Tomgroot/zigbee-indicator-light/hardware/reference/ESP32-H2-Zero-size.jpg

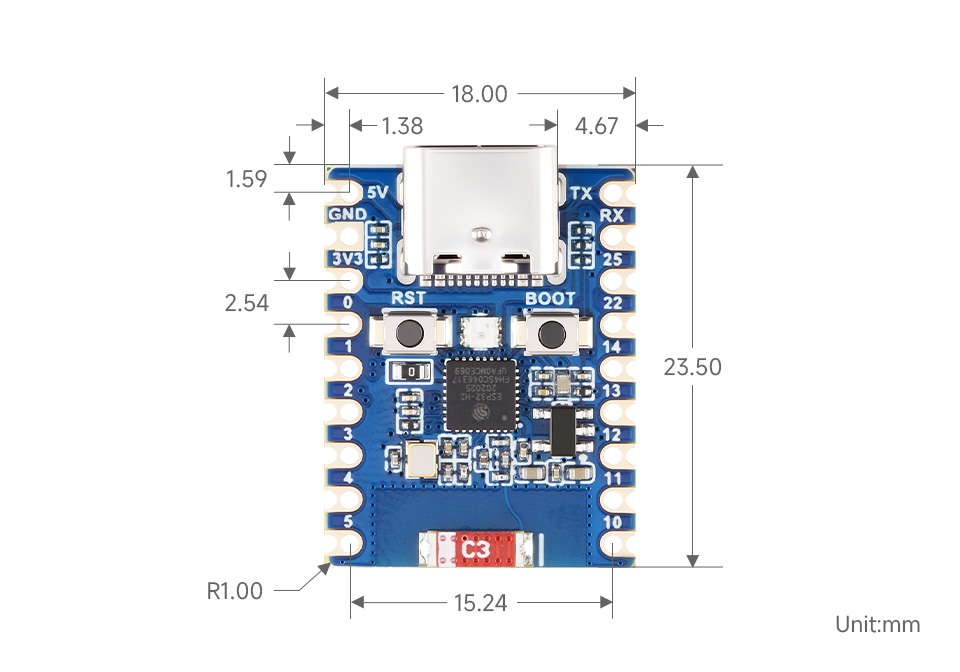
hardware/reference/ESP32-H2-Zero-size.jpg
