Tomgroot/zigbee-indicator-light/hardware/circuit_diagram.png

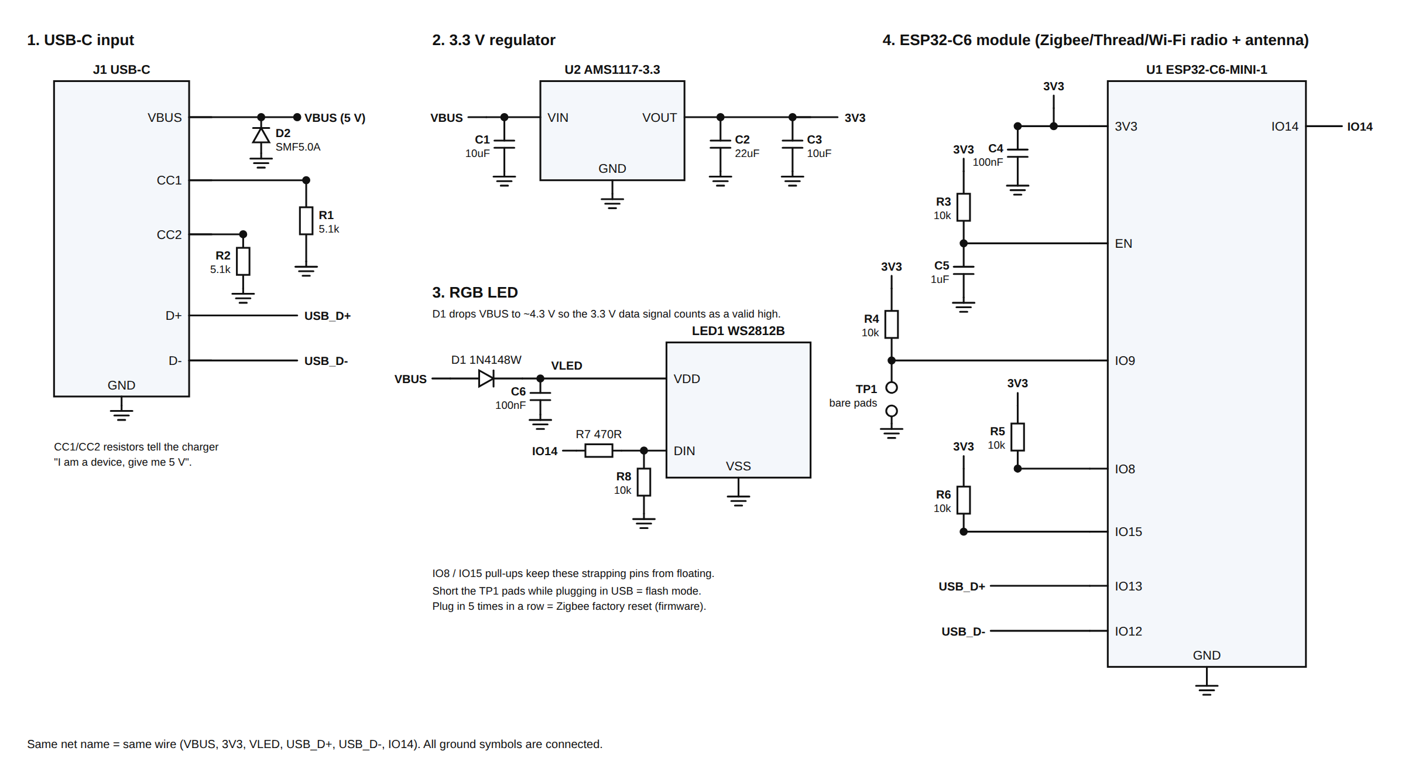
hardware/circuit_diagram.png
