Tomgroot/zigbee-indicator-light/hardware/bom.csv

Comment | Designator | Footprint | JLCPCB Part #（optional） | JLC type
ESP32-C6-MINI-1-N4 | U1 | ESP32-C6-MINI-1 | C5736265 | Extended
AP2114H-3.3 | U2 | SOT-223 | C150716 | Extended
TYPE-C-31-M-12 (USB-C 16p) | J1 | USB-C SMD | C165948 | Extended
WS2812B-B-V6 | LED1 | 5050 | C52941391 | Extended
1N4148W | D1 | SOD-123 | C81598 | Basic
SMF5.0A (TVS) | D2 | SOD-123FL | C151296 | Extended
22uF | C2 | 0805 | C45783 | Basic
10uF | C1,C3 | 0805 | C15850 | Basic
1uF | C5 | 0603 | C15849 | Basic
100nF | C4,C6 | 0603 | C14663 | Basic
10k | R3,R4,R5,R6,R8 | 0603 | C25804 | Basic
5.1k | R1,R2 | 0603 | C23186 | Basic
470R | R7 | 0603 | C23179 | Basic
