Tomgroot/zigbee-indicator-light/hardware/base_indicator_light.stl

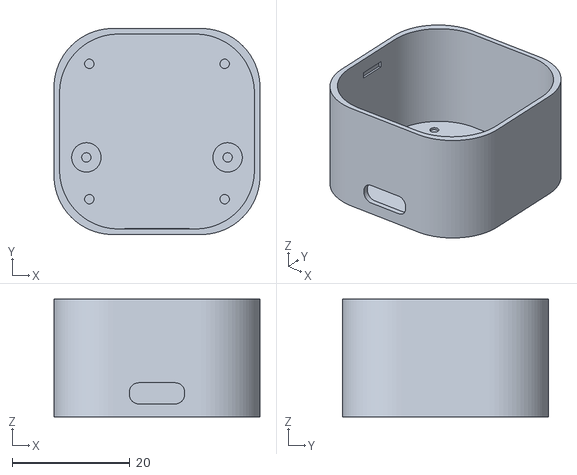
[picture p3: CAD file, 2026-11-05]
hardware/base_indicator_light.stl
35.0 x 35.0 x 20.0
