Tomgroot/zigbee-indicator-light/hardware/board_outline.dxf

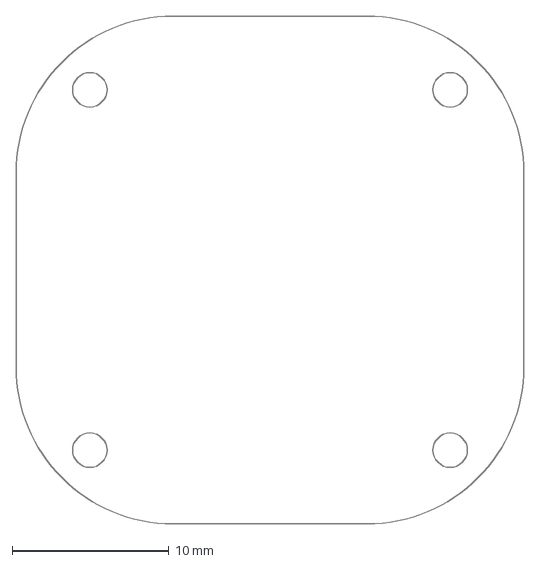
[picture p4: CAD file, 2026-11-03]
hardware/board_outline.dxf
32.4 x 32.4 mm
