Tomgroot/zigbee-indicator-light/hardware/cap_indicator_light.stl

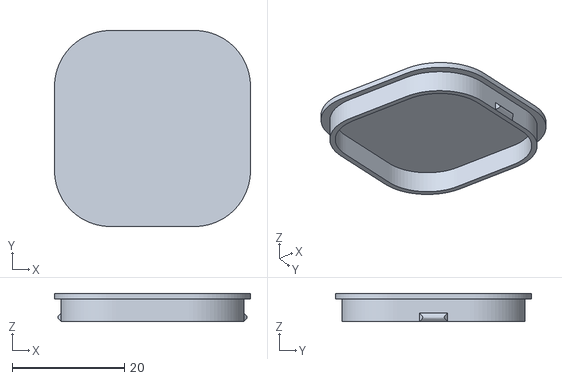
[picture p5: CAD file, 2026-10-31]
hardware/cap_indicator_light.stl
35.0 x 35.0 x 5.00
