Tomgroot/zigbee-indicator-light/hardware/cap.stl

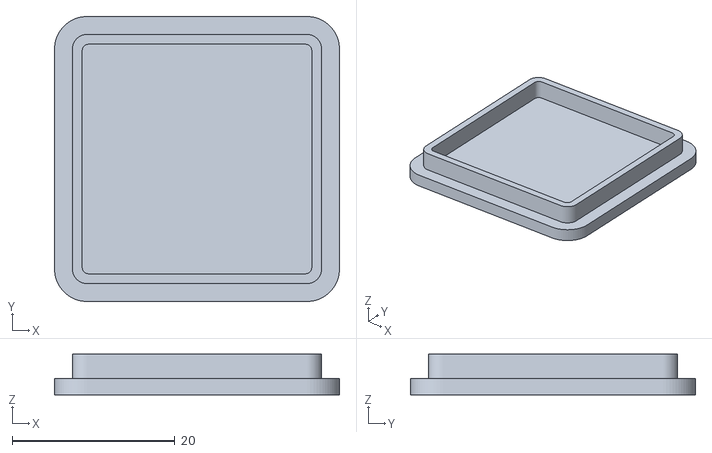
[picture p6: CAD file, 2026-10-30]
hardware/cap.stl
35.0 x 35.0 x 5.00
