Tomgroot/zigbee-indicator-light/hardware/body.stl

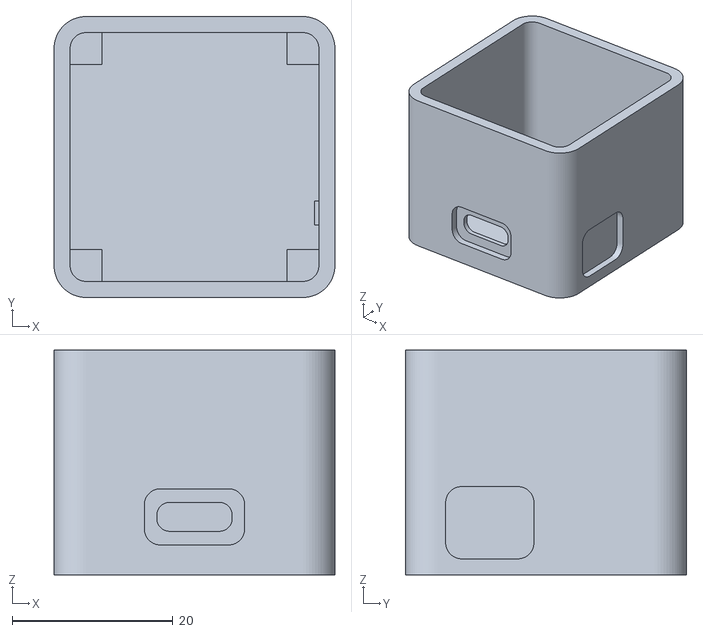
[picture p7: CAD file, 2026-10-30]
hardware/body.stl
35.0 x 35.0 x 28.0
