Tomgroot/zigbee-indicator-light/hardware/shield_zero.kicad_pcb

## KiCad design hardware/shield_zero.kicad_pcb (2026-11-05)

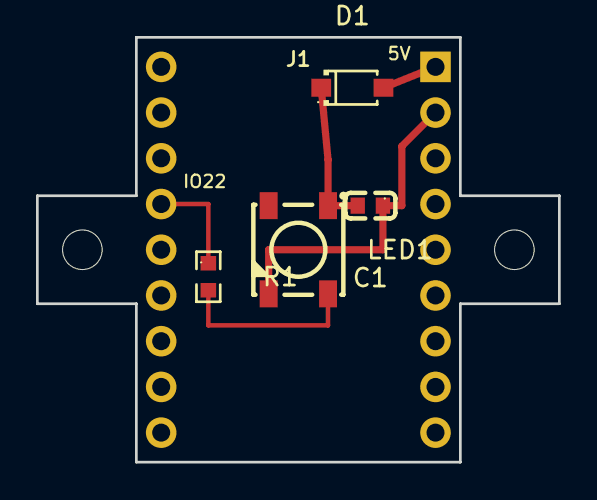
[picture p8: board shield_zero.kicad_pcb from above]

Board: 2 copper layers, 29.0 x 23.6 mm, 7 parts (0 on the bottom side), 5 nets.

Parts:
C1: 100nF; C0603
D1: 1N4148W; SOD-123F_L2.7-W1.6-LS3.8-RD
H1, H2: M2; MountingHole_2.2mm
J1: ESP32-H2-Zero; H2_Zero_2x9
LED1: SK6812-B; LED-SMD_4P-L5.0-W5.0-TL_WS2812B-B
R1: 470R; R0603

Connections:
5V: D1.2, J1.5V
GND: C1.1, J1.GND, LED1.3
LED_DIN: LED1.4, R1.2
LED_DIN_RAW: J1.IO22, R1.1
VLED: C1.2, D1.1, LED1.1
