Tomgroot/zigbee-indicator-light/hardware/board_routed.kicad_pcb

## KiCad design hardware/board_routed.kicad_pcb (2026-11-03)

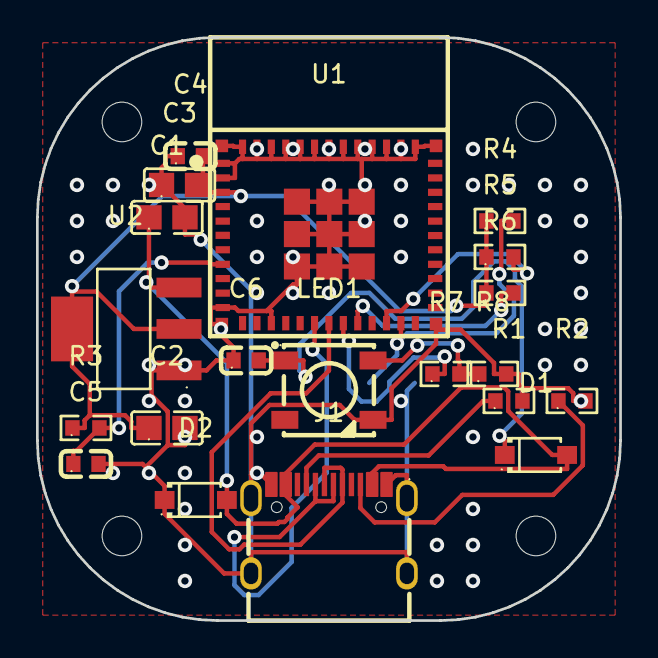
[picture p9: board board_routed.kicad_pcb from above]

Board: 2 copper layers, 32.4 x 32.4 mm, 25 parts (1 on the bottom side), 14 nets.

Parts:
C1, C3: 10uF; C0805
C2: 22uF; C0805
C4, C6: 100nF; C0603
C5: 1uF; C0603
D1: 1N4148W; SOD-123F_L2.7-W1.6-LS3.8-RD
D2: SMF5.0A; SOD-123F_L2.7-W1.6-LS3.8-RD
H1, H2, H3, H4: M2; MountingHole_2.2mm
J1: USB-C; USB-C_SMD-TYPE-C-31-M-12_1
LED1: WS2812B; LED-SMD_4P-L5.0-W5.0-TL_WS2812B-B
R1, R2: 5.1k; R0603
R3, R4, R5, R6, R8: 10k; R0603
R7: 470R; R0603
TP1: BOOT-GND; TESTPAD_BOOT
U1: ESP32-C6-MINI-1; WIFIM-SMD_61P-L16.6-W13.2-P0.80-ESP32-C6-MINI-1-N4
U2: AP2114H-3.3; SOT-223-3_L6.5-W3.4-P2.30-LS7.0-BR

Connections:
3V3: C2.1, C3.2, C4.2, R3.1, R4.1, R5.1, R6.1, U1.3, U2.2, U2.4
BOOT: R4.2, TP1.1, U1.23
CC1: J1.A5, R1.1
CC2: J1.B5, R2.1
EN: C5.1, R3.2, U1.8
GND: C1.2, C2.2, C3.1, C4.1, C5.2, C6.1, D2.1, J1.1, J1.2, J1.3, J1.4, J1.A1B12, J1.B1A12, LED1.3, R1.2, R2.2, R8.2, TP1.2, U1.1, U1.2, U1.11, U1.14, U1.36, U1.37, U1.38, U1.39, U1.40, U1.41, U1.42, U1.43, U1.44, U1.45, U1.46, U1.47, U1.48, U1.49, U1.50, U1.51, U1.52, U1.53, U2.1
IO8: R5.2, U1.22
IO14: R7.1, U1.19
IO15: R6.2, U1.20
LED_DIN: LED1.4, R7.2, R8.1
USB_DN: J1.A7, J1.B7, U1.17
USB_DP: J1.A6, J1.B6, U1.18
VBUS: C1.1, D1.2, D2.2, J1.A4B9, J1.B4A9, U2.3
VLED: C6.2, D1.1, LED1.1
