Tomgroot/zigbee-indicator-light/(commit log)

2025-12-13 First version of indicator light
    [partitions.csv]
2026-06-03 Working RGB led version
2026-10-30 Add hardware for indicator light
    [board_outline.dxf, body.stl, bom.csv, cap.stl]
2026-10-31 Add actual stl files for base and cap
    [base_indicator_light.stl, cap_indicator_light.stl]
2026-10-31 Add screws for indicator base
    [base_indicator_light.stl, board_outline.dxf, bom.csv, cap_indicator_light.stl]
2026-11-03 Fix hardware design in kicad
    [base_indicator_light.stl, board.kicad_pcb, board_outline.dxf, board_routed.kicad_pcb, bom.csv]
2026-11-03 Replace with C6 in-stock board
    [board.kicad_pcb, board_routed.kicad_pcb, bom.csv]
2026-11-03 Add cpl and add not default warnings
    [bom.csv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]
2026-11-05 Add shield for both H2-mini and H2-Zero
    [base_indicator_light.stl, shield.kicad_pcb, shield_bom.csv, shield_zero.kicad_pcb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]
